gemarcano/uart_isolator/uart_isolator.kicad_pcb

## KiCad design uart_isolator.kicad_pcb (2024-12-05)

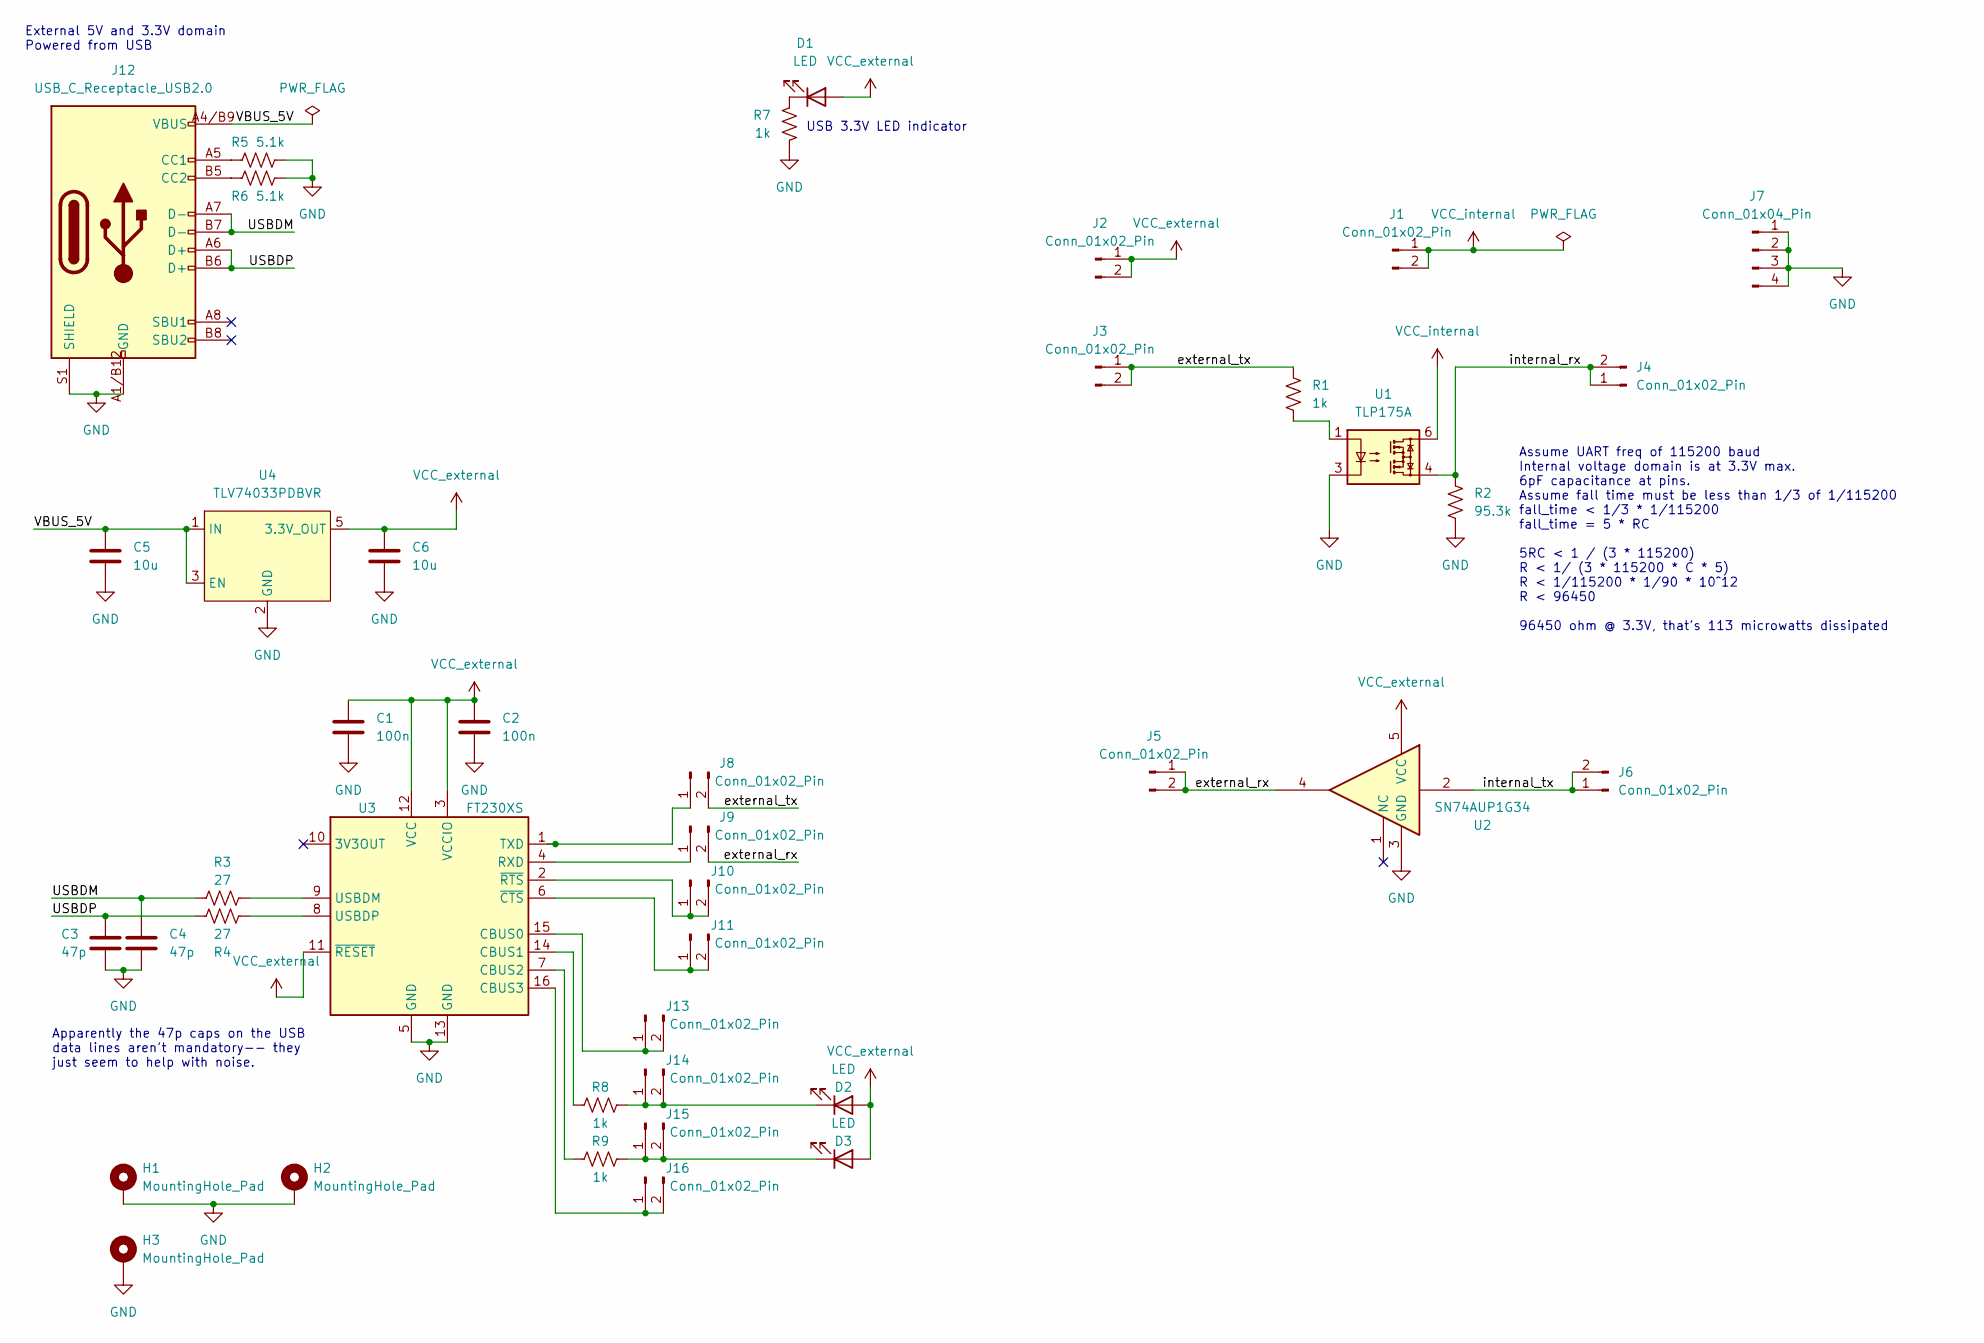
[picture p1: schematic uart_isolator.kicad_sch, UART Isolator]

Parts:
C1, C2: 100n; C_0603_1608Metric_Pad1.08x0.95mm_HandSolder; Digikey Product Number 1276-1935-2-ND
C3, C4: 47p; C_0603_1608Metric_Pad1.08x0.95mm_HandSolder; Digikey Product Number 1276-1037-2-ND
C5, C6: 10u; C_0603_1608Metric_Pad1.08x0.95mm_HandSolder; Digikey Product Number 1276-1119-1-ND
D1, D2, D3: LED; LED_0603_1608Metric_Pad1.05x0.95mm_HandSolder; Digikey Product Number 732-12016-2-ND
H1, H2, H3: MountingHole_Pad; MountingHole_2.2mm_M2_Pad_Via
J1, J2, J3, J4, J5, J6, J8, J9, J10, J11, J13, J14, J15, J16: Conn_01x02_Pin; PinHeader_1x02_P2.54mm_Vertical
J7: Conn_01x04_Pin; PinHeader_1x04_P2.54mm_Vertical
J12: USB_C_Receptacle_USB2.0; USB4105-GF-A; Digikey Product Number 2073-USB4105-GF-ACT-ND
R1, R7, R8, R9: 1k; R_0603_1608Metric_Pad0.98x0.95mm_HandSolder; Digikey Product Number RMCF0603FT1K00TR-ND
R2: 95.3k; R_0603_1608Metric_Pad0.98x0.95mm_HandSolder; Digikey Product Number 13-AC0603FR-0795K3LCT-ND
R3, R4: 27; R_0603_1608Metric_Pad0.98x0.95mm_HandSolder; Digikey Product Number CR0603-FX-27R0ELFTR-ND
R5, R6: 5.1k; R_0603_1608Metric_Pad0.98x0.95mm_HandSolder; Digikey Product Number RMCF0603FT5K10TR-ND
U1: TLP175A; MFSOP6-4_4.4x3.6mm_P1.27mm; Digikey Product Number TLP175A(TPLECT-ND
U2: SN74AUP1G34; SOT-23-5_HandSoldering; Digikey Product Number 296-19080-1-ND
U3: FT230XS; SSOP-16_3.9x4.9mm_P0.635mm; Digikey Product Number 768-1135-2-ND
U4: TLV74033PDBVR; SOT-23-5_HandSoldering; Digikey Product Number 296-TLV74033PDBVRCT-ND

Connections:
/USBDM: C4.1, J12.A7 (D-), J12.B7 (D-), R3.1
/USBDP: C3.1, J12.A6 (D+), J12.B6 (D+), R4.1
/VBUS_5V: C5.1, J12.A4/B9 (VBUS), J12.A9/B4 (VBUS), U4.1 (IN), U4.3 (EN)
/external_rx: J5.1, J5.2, J9.2, U2.4
/external_tx: J3.1, J3.2, J8.2, R1.1
/internal_rx: J4.1, J4.2, R2.1, U1.4
/internal_tx: J6.1, J6.2, U2.2
GND: C1.2, C2.2, C3.2, C4.2, C5.2, C6.2, H1.1, H2.1, H3.1, J7.1, J7.2, J7.3, J7.4, J12.A1/B12 (GND), J12.A12/B1 (GND), J12.S1 (SHIELD), R2.2, R5.2, R6.2, R7.2, U1.3, U2.3 (GND), U3.5 (GND), U3.13 (GND), U4.2 (GND)
unnamed: D1.1 (K), R7.1
unnamed: D2.1 (K), J14.1, J14.2, R8.1
unnamed: D3.1 (K), J15.1, J15.2, R9.1
unnamed: J8.1, U3.1 (TXD)
unnamed: J9.1, U3.4 (RXD)
unnamed: J10.1, J10.2, U3.2 (~RTS)
unnamed: J11.1, J11.2, U3.6 (~CTS)
unnamed: J12.A5 (CC1), R5.1
unnamed: J12.B5 (CC2), R6.1
unnamed: J13.1, J13.2, U3.15 (CBUS0)
unnamed: J16.1, J16.2, U3.16 (CBUS3)
unnamed: R1.2, U1.1
unnamed: R8.2, U3.14 (CBUS1)
unnamed: R9.2, U3.7 (CBUS2)
unnamed: R3.2, U3.9 (USBDM)
unnamed: R4.2, U3.8 (USBDP)
VCC_external: C1.1, C2.1, C6.1, D1.2 (A), D2.2 (A), D3.2 (A), J2.1, J2.2, U2.5 (VCC), U3.3 (VCCIO), U3.11 (~RESET), U3.12 (VCC), U4.5 (3.3V_OUT)
VCC_internal: J1.1, J1.2, U1.6

Notes on the sheet:
External 5V and 3.3V domain Powered from USB
USB 3.3V LED indicator
Assume UART freq of 115200 baud Internal voltage domain is at 3.3V max. 6pF capacitance at pins. Assume fall time must be less than 1/3 of 1/115200 fall_time < 1/3 * 1/115200 fall_time = 5 * RC 5RC < 1 / (3 * 115200) R < 1/ (3 * 115200 * C * 5) R < 1/115200 * 1/90 * 10^12 R < 96450 96450 ohm @ 3.3V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
Apparently the 47p caps on the USB data lines aren't mandatory-- they just seem to help with noise.

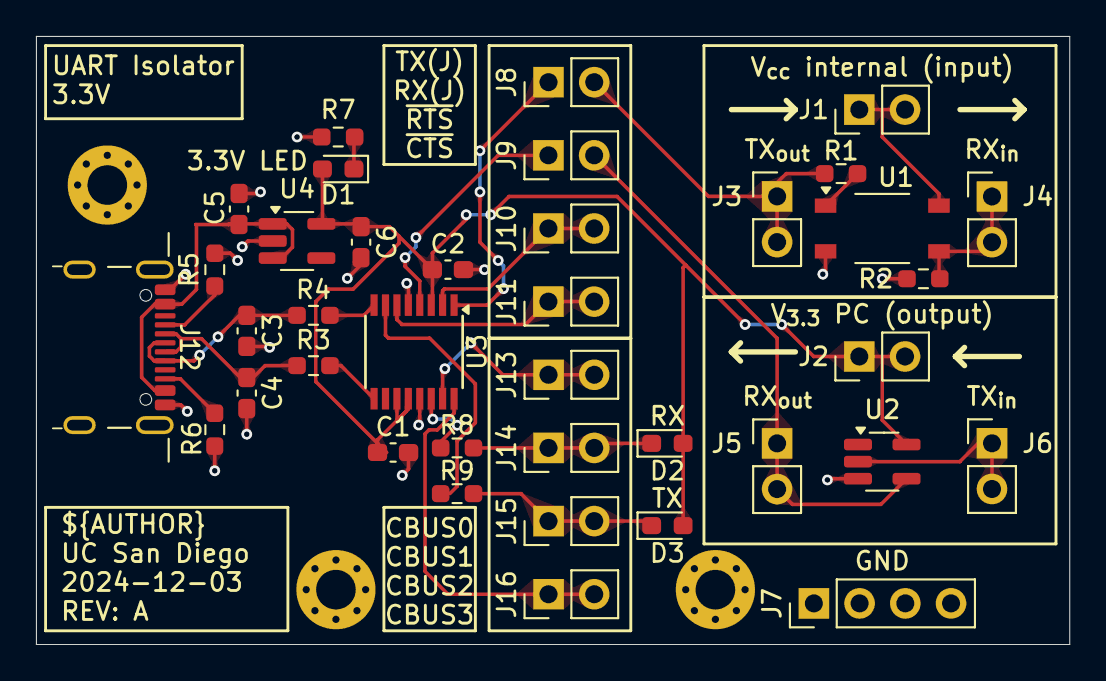
[picture p2: board uart_isolator.kicad_pcb from above]

Board: 2 copper layers, 57.4 x 33.8 mm, 41 parts (0 on the bottom side), 26 nets.
