gemarcano/uart_isolator/(commit log)

2024-11-06 Change to using voltage buffer
    - Silkmask updates to clarify labels
    - Using voltage buffer to isolate TX_in from RX_out
    [uart_isolator.kicad_pcb, uart_isolator.kicad_sch]
2024-12-05 Rev A
    [uart_isolator.kicad_pcb, uart_isolator.kicad_sch]
